taseraul/greenhouse-controller/hardware/bom.xlsx

Comment | Designator | Footprint | LCSC Part #（optional）
2N7002 | Q1,Q5,Q3 | SOT-23 | C8545 (https://lcsc.com/product-detail/MOSFET_Changjiang-Electronics-Tech-CJ-2N7002_C8545.html/?href=jlc-SMT)
ESP-12F | U2 | ESP-12E_SMD | C82891 (https://lcsc.com/product-detail/WIFI-Modules_Ai-Thinker-ESP-12F-ESP8266MOD_C82891.html/?href=jlc-SMT)
0 | R25,R24,R23,R22,R9 | R_0402_1005Metric | C17168 (https://lcsc.com/product-detail/Chip-Resistor-Surface-Mount_UNI-ROYAL-Uniroyal-Elec-0402WGF0000TCE_C17168.html/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)
4 x AA(A) | BT1 | PinHeader_1x02_P2.54mm_Vertical
10u/6.3V | C13,C11,C10,C9,C6,C5,C1 | C_0402_1005Metric | C15525 (https://lcsc.com/product-detail/Multilayer-Ceramic-Capacitors-MLCC-SMD-SMT_Samsung-Electro-Mechanics-CL05A106MQ5NUNC_C15525.html/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)
10k | R21,R18,R15,R11,R8,R7,R2 | R_0402_1005Metric | C25744 (https://lcsc.com/product-detail/Chip-Resistor-Surface-Mount_UNI-ROYAL-Uniroyal-Elec-0402WGF1002TCE_C25744.html/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)
4.3 | R14,R17 | R_0603_1608Metric
1k | R20,R19,R13 | R_0402_1005Metric | C11702 (https://lcsc.com/product-detail/Chip-Resistor-Surface-Mount_UNI-ROYAL-Uniroyal-Elec-0402WGF1001TCE_C11702.html/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)
BLUE | D9 | LED_0805_2012Metric | C2293 (https://lcsc.com/product-detail/Light-Emitting-Diodes-LED_Hubei-KENTO-Elec-C2293_C2293.html/?href=jlc-SMT)
ORANGE | D8 | LED_0805_2012Metric | C2296 (https://lcsc.com/product-detail/Light-Emitting-Diodes-LED_Hubei-KENTO-Elec-17-21SUYC-TR8_C2296.html/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)
18650 | BT2 | 1043
MountingHole_Pad | H3,H2,H1 | MountingHole_3.7mm_Pad
SW_Push | RESET1,PB2,PB1,FLASH1 | SW_SPST_EVQP7A
Conn_01x03 | TEMP1,Analog3,Analog2 | JST_PH_S3B-PH-SM4-TB_1x03-1MP_P2.00mm_Horizontal
Conn_01x04 | StepperMotor1,PROG1 | JST_PH_S4B-PH-SM4-TB_1x04-1MP_P2.00mm_Horizontal
Conn_01x02 | J5 | JST_PH_S2B-PH-SM4-TB_1x02-1MP_P2.00mm_Horizontal
HT75xx-1-SOT89 | U3 | SOT-89-3 | C14289 (https://lcsc.com/product-detail/Dropout-Regulators-LDO_Holtek-Semicon-HT7533-1_C14289.html/?href=jlc-SMT)
ATtiny45-20SU | U1 | SOIJ-8_5.3x5.3mm_P1.27mm | C152211 (https://lcsc.com/product-detail/MICROCHIP_Microchip-Tech-ATTINY45-20SUR_C152211.html/?href=jlc-SMT)
1.6k - 1.8k | R16 | R_0603_1608Metric | C17398 (https://lcsc.com/product-detail/Chip-Resistor-Surface-Mount_Uniroyal-Elec-0805W8F1801T5E_C17398.html/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)
4.7k | R12,R6,R5 | R_0402_1005Metric | C25900 (https://lcsc.com/product-detail/Chip-Resistor-Surface-Mount_Uniroyal-Elec-0402WGF4701TCE_C25900.html/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)
300k | R10 | R_0402_1005Metric | C25774 (https://lcsc.com/product-detail/Chip-Resistor-Surface-Mount_UNI-ROYAL-Uniroyal-Elec-0402WGF3003TCE_C25774.html/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)
47k | R4 | R_0402_1005Metric | C25792 (https://lcsc.com/product-detail/Chip-Resistor-Surface-Mount_UNI-ROYAL-Uniroyal-Elec-0402WGF4702TCE_C25792.html/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)
100k | R3 | R_0402_1005Metric | C25741 (https://lcsc.com/product-detail/Chip-Resistor-Surface-Mount_UNI-ROYAL-Uniroyal-Elec-0402WGF1003TCE_C25741.html/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)
33k | R1 | R_0402_1005Metric | C25779 (https://lcsc.com/product-detail/Chip-Resistor-Surface-Mount_UNI-ROYAL-Uniroyal-Elec-0402WGF3302TCE_C25779.html/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)
Si2319CDS | Q4,Q2 | SOT-23 | C10487 (https://lcsc.com/product-detail/MOSFET_Vishay-Intertech-SI2301CDS-T1-GE3_C10487.html/?href=jlc-SMT)
Conn_02x03 | Microstep1 | PinHeader_2x03_P2.54mm_Vertical_SMD
3.3u | L1 | L_Bourns-SRN4018 | C408336 (https://lcsc.com/product-detail/Power-Inductors_Sunlord-MWSA0402S-3R3MT_C408336.html/?href=jlc-SMT)
ADW1103HLW | K1 | ADW1103HLW
Conn_01x02 | J4 | TerminalBlock_Phoenix_MKDS-1,5-2_1x02_P5.00mm_Horizontal
Barrel_Jack_Switch | J3 | BarrelJack_Wuerth_6941xx301002
Conn_02x03_Odd_Even | J2 | PinHeader_2x03_P2.54mm_Vertical_SMD
USB_B_Micro | J1 | USB_Micro-B_Molex-105017-0001
TP4054 | IC2 | SOT95P280X100-5N | C32574 (https://lcsc.com/product-detail/PMIC-Battery-Management_TOPPOWER-Nanjing-Extension-Microelectronics-TP4054_C32574.html/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)
MP2451DT-LF-Z | IC1 | SOT95P280X145-6N | C14123 (https://lcsc.com/product-detail/DC-DC-Converters_Monolithic-Power-Systems-MP2451DT-LF-Z_C14123.html/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)
D_Schottky | D7,D6,D5,D4,D1 | D_SOD-123 | C8598 (https://lcsc.com/product-detail/Schottky-Barrier-Diodes-SBD_Changjiang-Electronics-Tech-CJ-B5819W_C8598.html/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)
RED | D3 | LED_0805_2012Metric | C2297 (https://lcsc.com/product-detail/Light-Emitting-Diodes-LED_Hubei-KENTO-Elec-C2297_C2297.html/?href=jlc-SMT)
GREEN | D2 | LED_0805_2012Metric | C2296 (https://lcsc.com/product-detail/Light-Emitting-Diodes-LED_Hubei-KENTO-Elec-17-21SUYC-TR8_C2296.html/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)
10u/10V | C12 | C_0603_1608Metric | C19702 (https://lcsc.com/product-detail/Multilayer-Ceramic-Capacitors-MLCC-SMD-SMT_Samsung-Electro-Mechanics-CL10A106KP8NNNC_C19702.html/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)
10u/36V | C8 | C_1206_3216Metric | C13585 (https://lcsc.com/product-detail/Multilayer-Ceramic-Capacitors-MLCC-SMD-SMT_SAMSUNG_CL31A106KBHNNNE_10uF-106-10-50V_C13585.html/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)
100u/36V | C7 | CP_Elec_8x10
4.7u/36V | C4 | C_1206_3216Metric | C29823 (https://lcsc.com/product-detail/Multilayer-Ceramic-Capacitors-MLCC-SMD-SMT_FH-Guangdong-Fenghua-Advanced-Tech-1206B475K500NT_C29823.html/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)
100n | C3 | C_0402_1005Metric | C1525 (https://lcsc.com/product-detail/Multilayer-Ceramic-Capacitors-MLCC-SMD-SMT_Samsung-Electro-Mechanics-CL05B104KO5NNNC_C1525.html/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)
33p | C2 | C_0402_1005Metric | C1562 (https://lcsc.com/product-detail/Multilayer-Ceramic-Capacitors-MLCC-SMD-SMT_FH-Guangdong-Fenghua-Advanced-Tech-0402CG330J500NT_C1562.html/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)
Pololu_Breakout_A4988 | A1 | Pololu_Breakout-16_15.2x20.3mm
