taseraul/greenhouse-controller/hardware/hardware.kicad_pcb

## KiCad design hardware/hardware.kicad_pcb (2021-05-06)

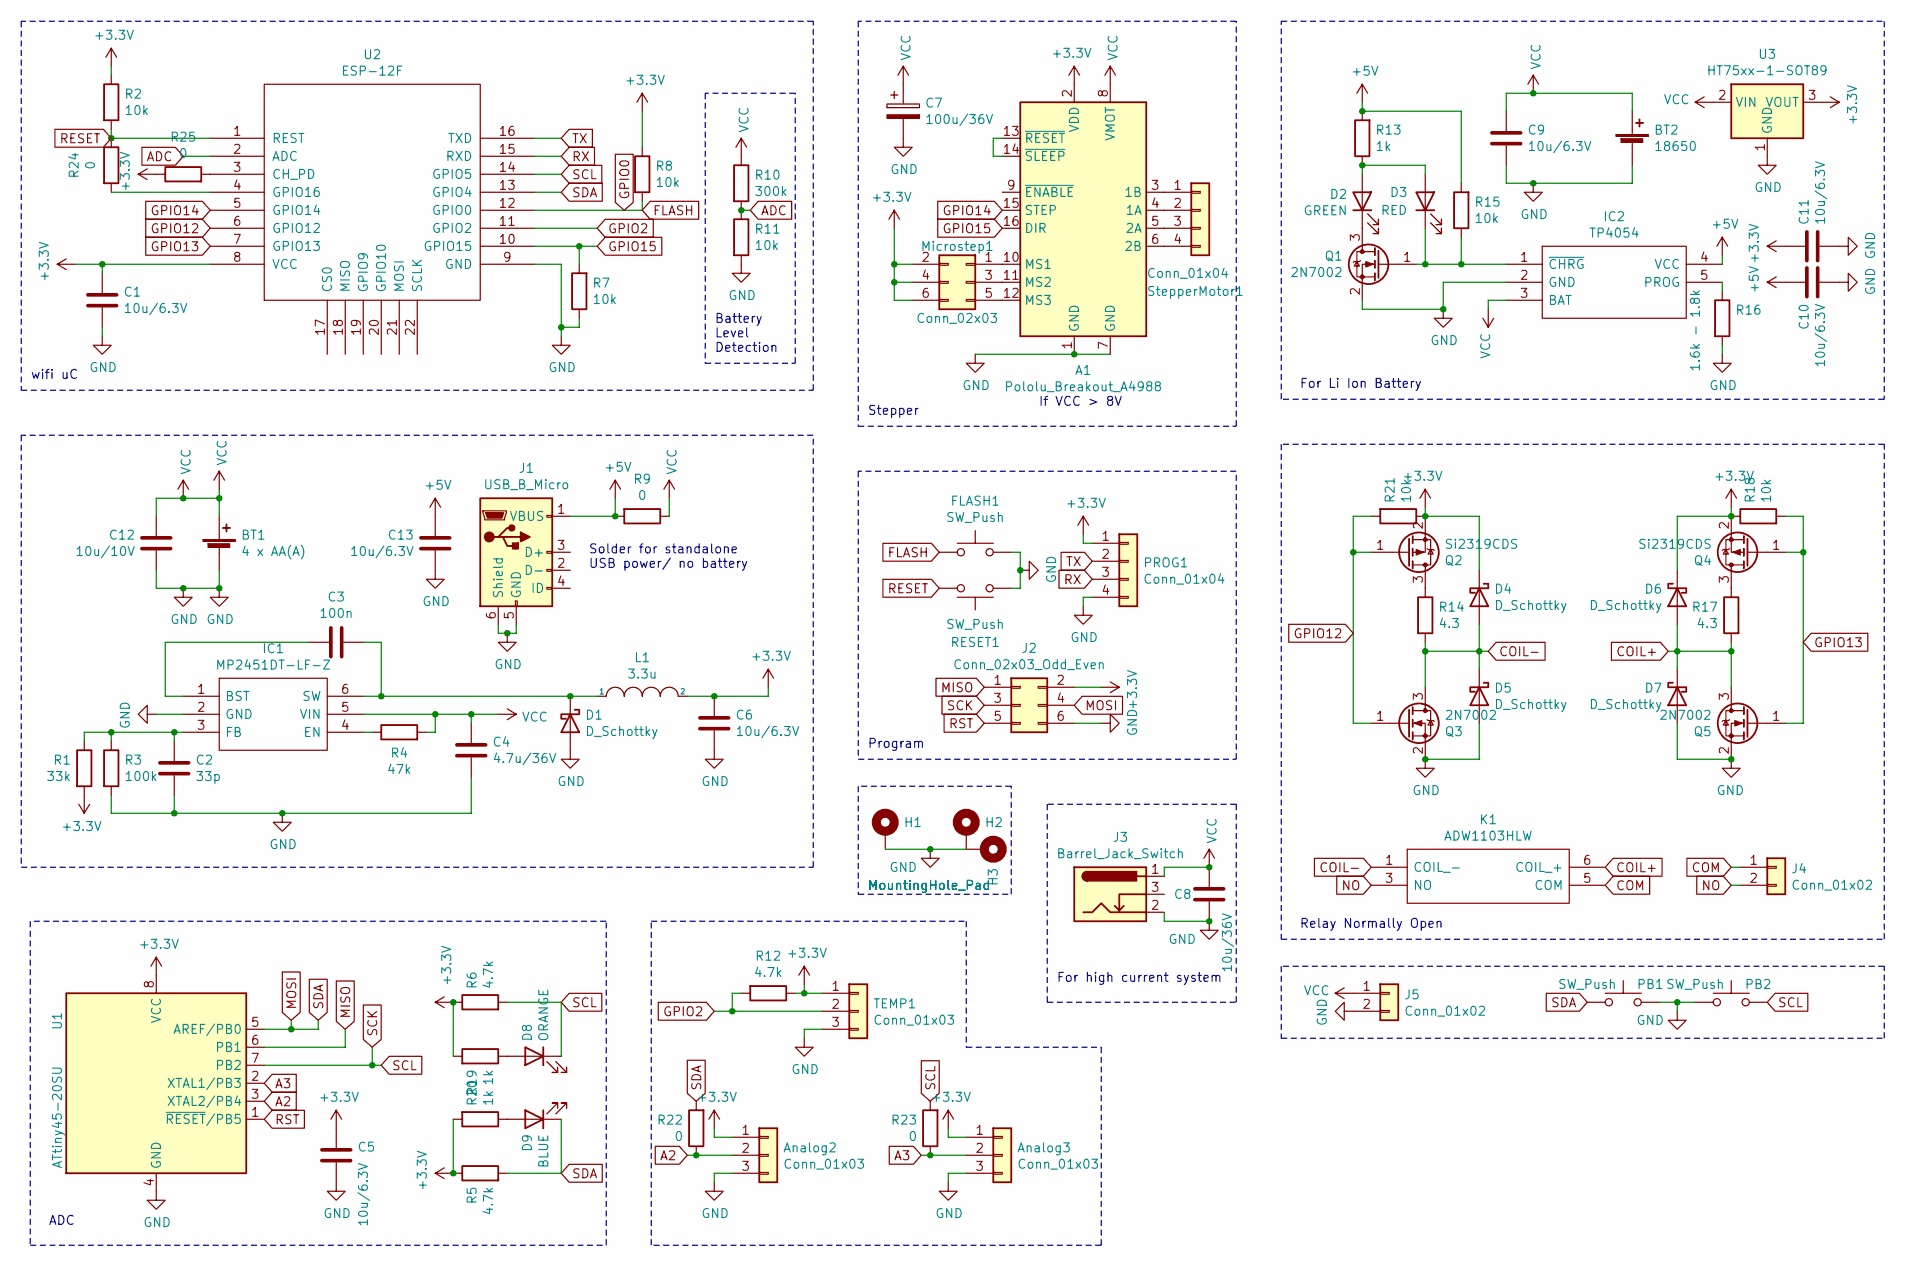
[picture p1: schematic hardware.sch]

Parts:
A1: Pololu_Breakout_A4988; Pololu_Breakout-16_15.2x20.3mm
Analog2, Analog3: Conn_01x03; JST_PH_S3B-PH-SM4-TB_1x03-1MP_P2.00mm_Horizontal
BT1: 4 x AA(A); PinHeader_1x02_P2.54mm_Vertical
BT2: 18650; 1043
C1, C5, C6, C9, C10, C11, C13: 10u/6.3V; C_0402_1005Metric
C2: 33p; C_0402_1005Metric
C3: 100n; C_0402_1005Metric
C4: 4.7u/36V; C_1206_3216Metric
C7: 100u/36V; CP_Elec_8x10
C8: 10u/36V; C_1206_3216Metric
C12: 10u/10V; C_0603_1608Metric
D1, D4, D5, D6, D7: D_Schottky; D_SOD-123
D2: GREEN; LED_0805_2012Metric
D3: RED; LED_0805_2012Metric
D8: ORANGE; LED_0805_2012Metric
D9: BLUE; LED_0805_2012Metric
FLASH1: SW_Push; SW_SPST_EVQP7A
H1, H2, H3: MountingHole_Pad; MountingHole_3.7mm_Pad
IC1: MP2451DT-LF-Z; SOT95P280X145-6N; Mouser Part Number 946-MP2451DTLFZ
IC2: TP4054; SOT95P280X100-5N; Manufacturer_Part_Number TP4054
J1: USB_B_Micro; USB_Micro-B_Molex-105017-0001
J2: Conn_02x03_Odd_Even; PinHeader_2x03_P2.54mm_Vertical_SMD
J3: Barrel_Jack_Switch; BarrelJack_Wuerth_6941xx301002
J4: Conn_01x02; TerminalBlock_Phoenix_MKDS-1,5-2_1x02_P5.00mm_Horizontal
J5: Conn_01x02; JST_PH_S2B-PH-SM4-TB_1x02-1MP_P2.00mm_Horizontal
K1: ADW1103HLW; Mouser Part Number 769-ADW1103HLW
L1: 3.3u; L_Bourns-SRN4018
Microstep1: Conn_02x03; PinHeader_2x03_P2.54mm_Vertical_SMD
PB1, PB2: SW_Push; SW_SPST_EVQP7A
PROG1: Conn_01x04; JST_PH_S4B-PH-SM4-TB_1x04-1MP_P2.00mm_Horizontal
Q1, Q3, Q5: 2N7002; SOT-23
Q2, Q4: Si2319CDS; SOT-23
R1: 33k; R_0402_1005Metric
R2, R7, R8, R11, R15, R18, R21: 10k; R_0402_1005Metric
R3: 100k; R_0402_1005Metric
R4: 47k; R_0402_1005Metric
R5, R6, R12: 4.7k; R_0402_1005Metric
R9, R22, R23, R24, R25: 0; R_0402_1005Metric
R10: 300k; R_0402_1005Metric
R13, R19, R20: 1k; R_0402_1005Metric
R14, R17: 4.3; R_0603_1608Metric
R16: 1.6k - 1.8k; R_0805_2012Metric
RESET1: SW_Push; SW_SPST_EVQP7A
StepperMotor1: Conn_01x04; JST_PH_S4B-PH-SM4-TB_1x04-1MP_P2.00mm_Horizontal
TEMP1: Conn_01x03; JST_PH_S3B-PH-SM4-TB_1x03-1MP_P2.00mm_Horizontal
U1: ATtiny45-20SU; SOIJ-8_5.3x5.3mm_P1.27mm
U2: ESP-12F; ESP-12E_SMD
U3: HT75xx-1-SOT89; SOT-89-3

Connections:
+3V3: A1.2 (VDD), Analog2.1, Analog3.1, C1.1, C5.1, C6.1, C11.1, D4.1 (K), D6.1 (K), J2.2, L1.2, Microstep1.2, Microstep1.4, Microstep1.6, PROG1.1, Q2.2 (S), Q4.2 (S), R1.2, R2.1, R5.1, R6.1, R8.1, R12.1, R18.1, R19.2, R20.2, R21.1, R25.1, TEMP1.1, U1.8 (VCC), U2.8 (VCC), U3.3 (VOUT)
+5V: C10.1, C13.1, IC2.4 (VCC), J1.1 (VBUS), R9.2, R13.2, R15.2
A2: Analog2.2, R22.1, U1.3 (XTAL2/PB4)
A3: Analog3.2, R23.1, U1.2 (XTAL1/PB3)
ADC: R10.2, R11.1, U2.2 (ADC)
COIL+: D6.2 (A), D7.1 (K), K1.6 (COIL_+), Q5.3 (D), R17.2
COIL-: D4.2 (A), D5.1 (K), K1.1 (COIL_-), Q3.3 (D), R14.2
COM: J4.1, K1.5 (COM)
FLASH: FLASH1.1, R8.2, U2.12 (GPIO0)
GND: A1.1 (GND), A1.7 (GND), Analog2.3, Analog3.3, BT1.2 (-), BT2.2 (-), C1.2, C2.2, C4.2, C5.2, C6.2, C7.2, C8.2, C9.2, C10.2, C11.2, C12.2, C13.2, D1.2 (A), D5.2 (A), D7.2 (A), FLASH1.2, H1.1, H2.1, H3.1, IC1.2 (GND), IC2.2 (GND), J1.5 (GND), J1.6 (Shield), J2.6, J3.2, J5.2, PB1.2, PB2.2, PROG1.4, Q1.2 (S), Q3.2 (S), Q5.2 (S), R3.2, R7.1, R11.2, R16.2, RESET1.2, TEMP1.3, U1.4 (GND), U2.9 (GND), U3.1 (GND)
GPIO2: R12.2, TEMP1.2, U2.11 (GPIO2)
GPIO12: Q2.1 (G), Q3.1 (G), R21.2, U2.6 (GPIO12)
GPIO13: Q4.1 (G), Q5.1 (G), R18.2, U2.7 (GPIO13)
GPIO14: A1.15 (STEP), U2.5 (GPIO14)
GPIO15: A1.16 (DIR), R7.2, U2.10 (GPIO15)
MISO: J2.1, U1.6 (PB1)
MOSI: D9.1 (K), J2.4, PB1.1, R5.2, R22.2, U1.5 (AREF/PB0), U2.13 (GPIO4)
NO: J4.2, K1.3 (NO)
unnamed: A1.3 (1B), StepperMotor1.1
unnamed: A1.4 (1A), StepperMotor1.2
unnamed: A1.5 (2A), StepperMotor1.3
unnamed: A1.6 (2B), StepperMotor1.4
unnamed: A1.10 (MS1), Microstep1.1
unnamed: A1.11 (MS2), Microstep1.3
unnamed: A1.12 (MS3), Microstep1.5
unnamed: A1.13 (~RESET), A1.14 (~SLEEP)
unnamed: C2.1, IC1.3 (FB), R1.1, R3.1
unnamed: C3.1, IC1.1 (BST)
unnamed: C3.2, D1.1 (K), IC1.6 (SW), L1.1
unnamed: D2.1 (K), Q1.3 (D)
unnamed: D2.2 (A), D3.2 (A), R13.1
unnamed: D3.1 (K), IC2.1 (~CHRG), Q1.1 (G), R15.1
unnamed: D8.2 (A), R19.1
unnamed: D9.2 (A), R20.1
unnamed: IC1.4 (EN), R4.1
unnamed: IC2.5 (PROG), R16.1
unnamed: Q2.3 (D), R14.1
unnamed: Q4.3 (D), R17.1
unnamed: R24.2, U2.4 (GPIO16)
unnamed: R25.2, U2.3 (CH_PD)
RESET: R2.2, R24.1, RESET1.1, U2.1 (REST)
RST: J2.5, U1.1 (~RESET~/PB5)
RX: PROG1.3, U2.15 (RXD)
SCK: D8.1 (K), J2.3, PB2.1, R6.2, R23.2, U1.7 (PB2), U2.14 (GPIO5)
TX: PROG1.2, U2.16 (TXD)
VCC: A1.8 (VMOT), BT1.1 (+), BT2.1 (+), C4.1, C7.1, C8.1, C9.1, C12.1, IC1.5 (VIN), IC2.3 (BAT), J3.1, J5.1, R4.2, R9.1, R10.1, U3.2 (VIN)

Notes on the sheet:
Solder for standalone USB power/ no battery
For high current system
For Li Ion Battery
Program
ADC
If VCC > 8V
Relay Normally Open
Stepper
wifi uC
Battery Level Detection

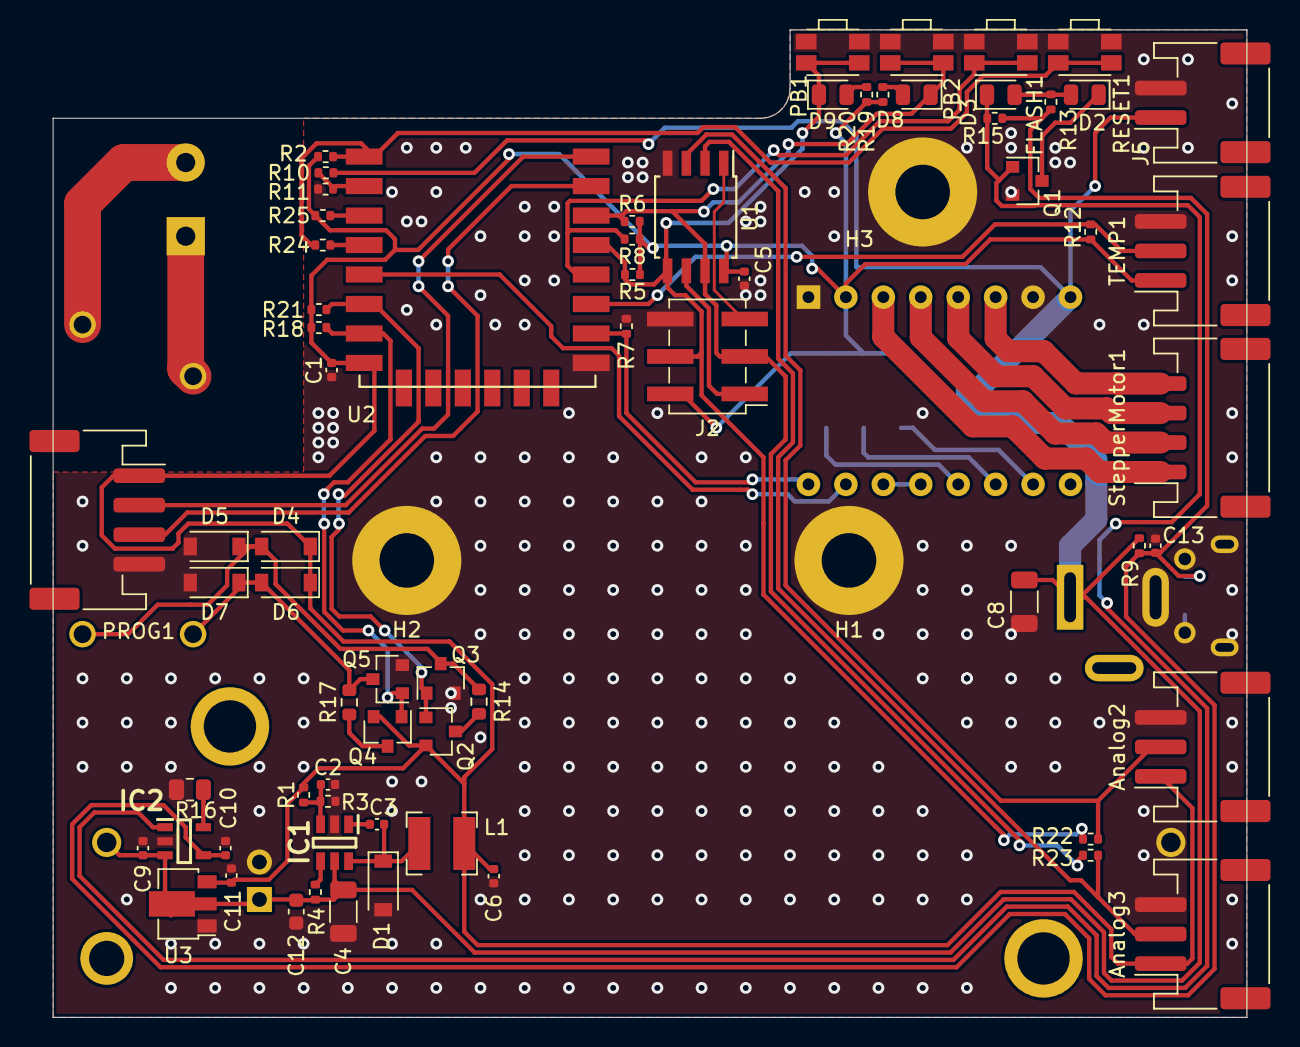
[picture p2: board hardware.kicad_pcb from above]

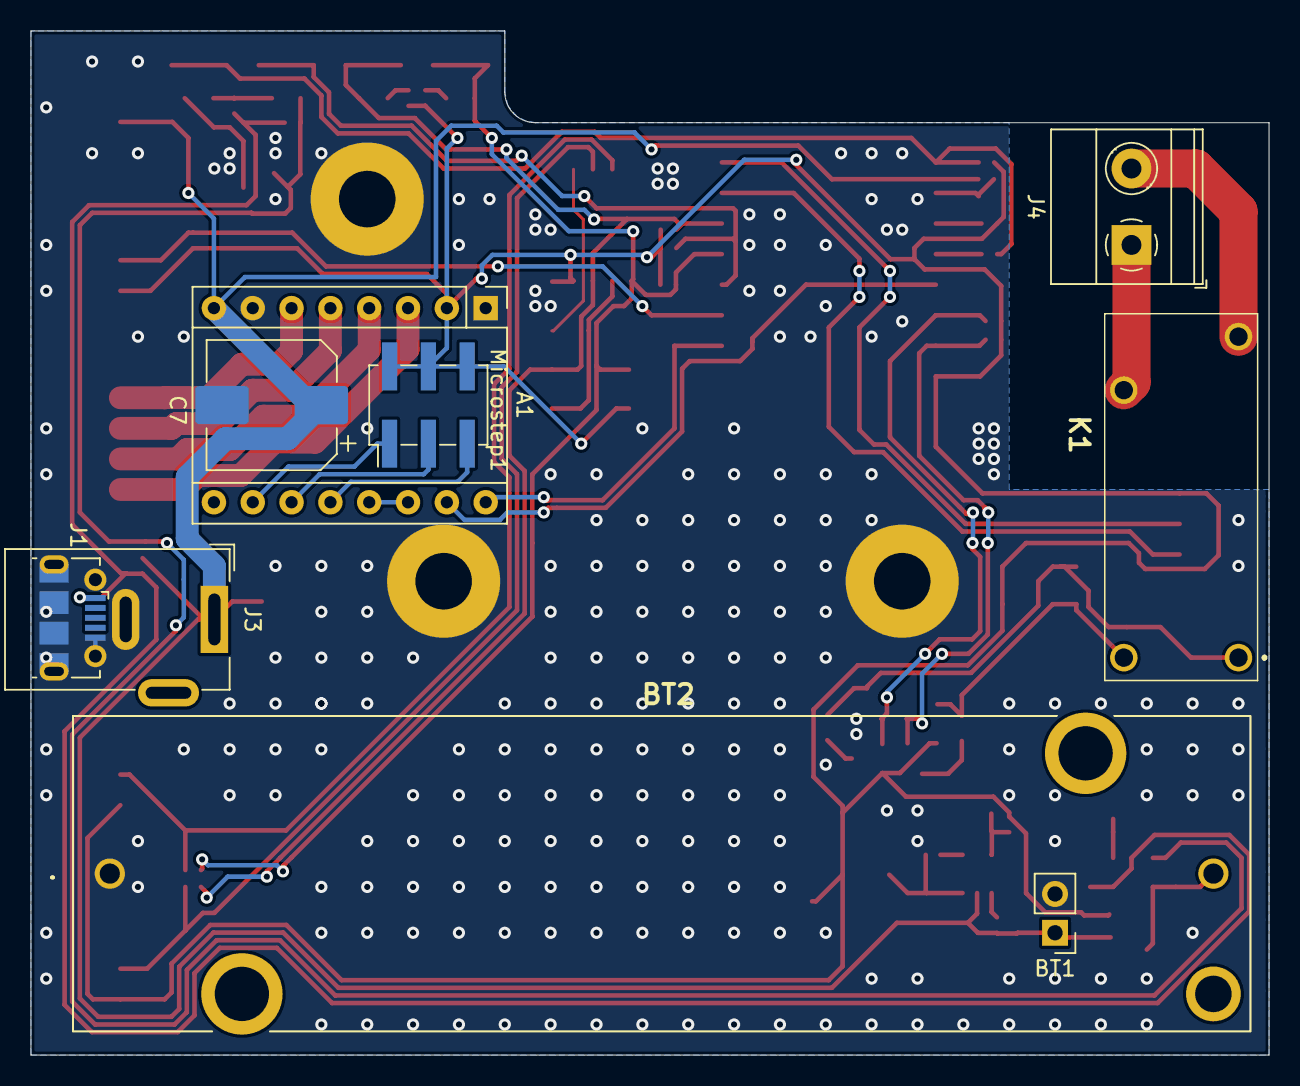
[picture p3: board hardware.kicad_pcb from below]

Board: 2 copper layers, 81.0 x 67.0 mm, 80 parts (9 on the bottom side), 46 nets.
